jcfrantz/estacao-do-clima-dwin/docs/figuras/fig1_conectar_porta.png

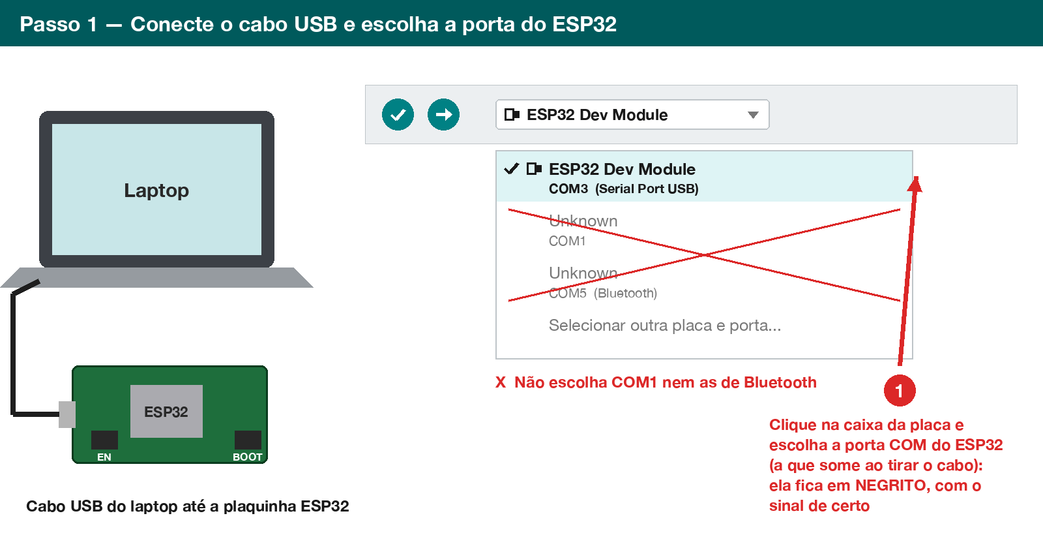
docs/figuras/fig1_conectar_porta.png
