jcfrantz/estacao-do-clima-dwin/docs/figuras/fig2_abrir_monitor.png

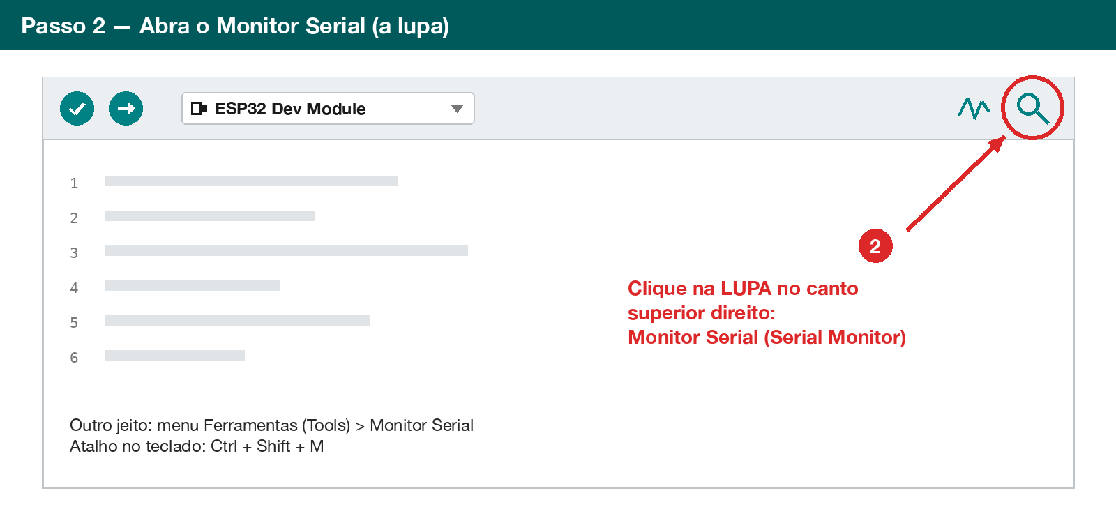
docs/figuras/fig2_abrir_monitor.png
