jcfrantz/estacao-do-clima-dwin/docs/figuras/fig3_configurar_digitar.png

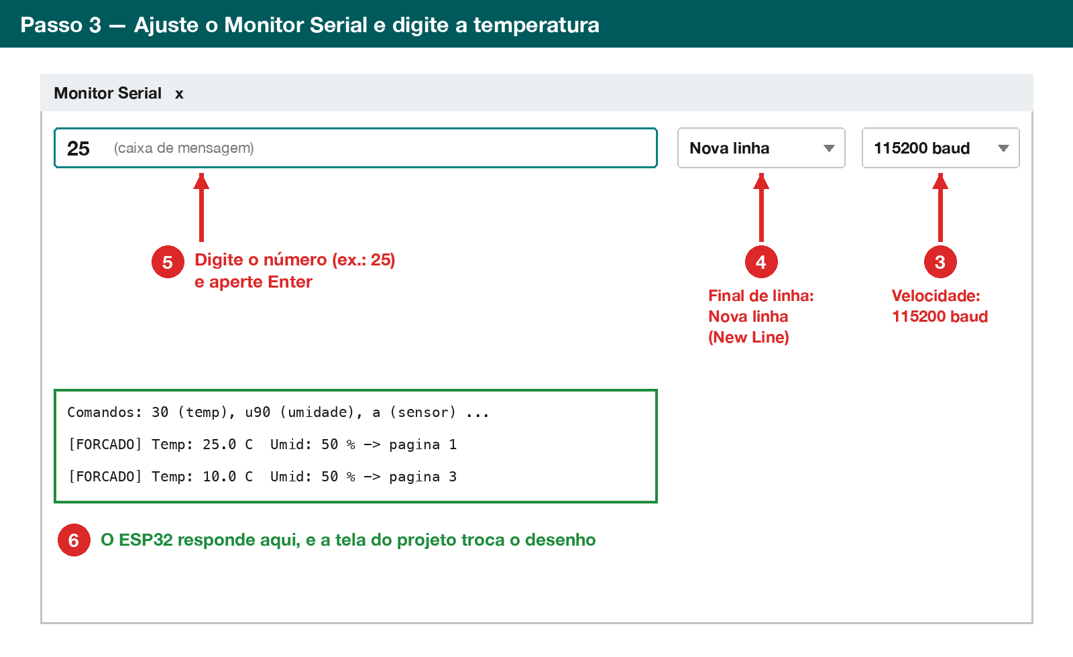
docs/figuras/fig3_configurar_digitar.png
