jcfrantz/estacao-do-clima-dwin/(commit log)

2026-10-26 Estação do Clima: ESP32 + tela DWIN com desenhos das crianças
    Firmware do ESP32 (DHT11, tela DWIN, DFPlayer, servo da boca),
    projeto gerado da tela (DWIN_SET), áudios provisórios do DFPlayer,
    desenhos em PNG e guia do professor em PDF.
2026-10-27 README: servo com fonte própria
    A tela DWIN apagava quando o servo fazia força na boca, mesmo com
    fonte de 3 A e capacitor de 1000 µF. Resolveu com fontes separadas
    (servo / tela + ESP32 + DFPlayer) e GNDs unidos.
